JRodrigoTech/ESP32-Reflow-Toaster-Oven-Controller/Hardware/Reflow-controller-ESP32.brd

## EAGLE design Hardware/Reflow-controller-ESP32.brd (2019-05-02)

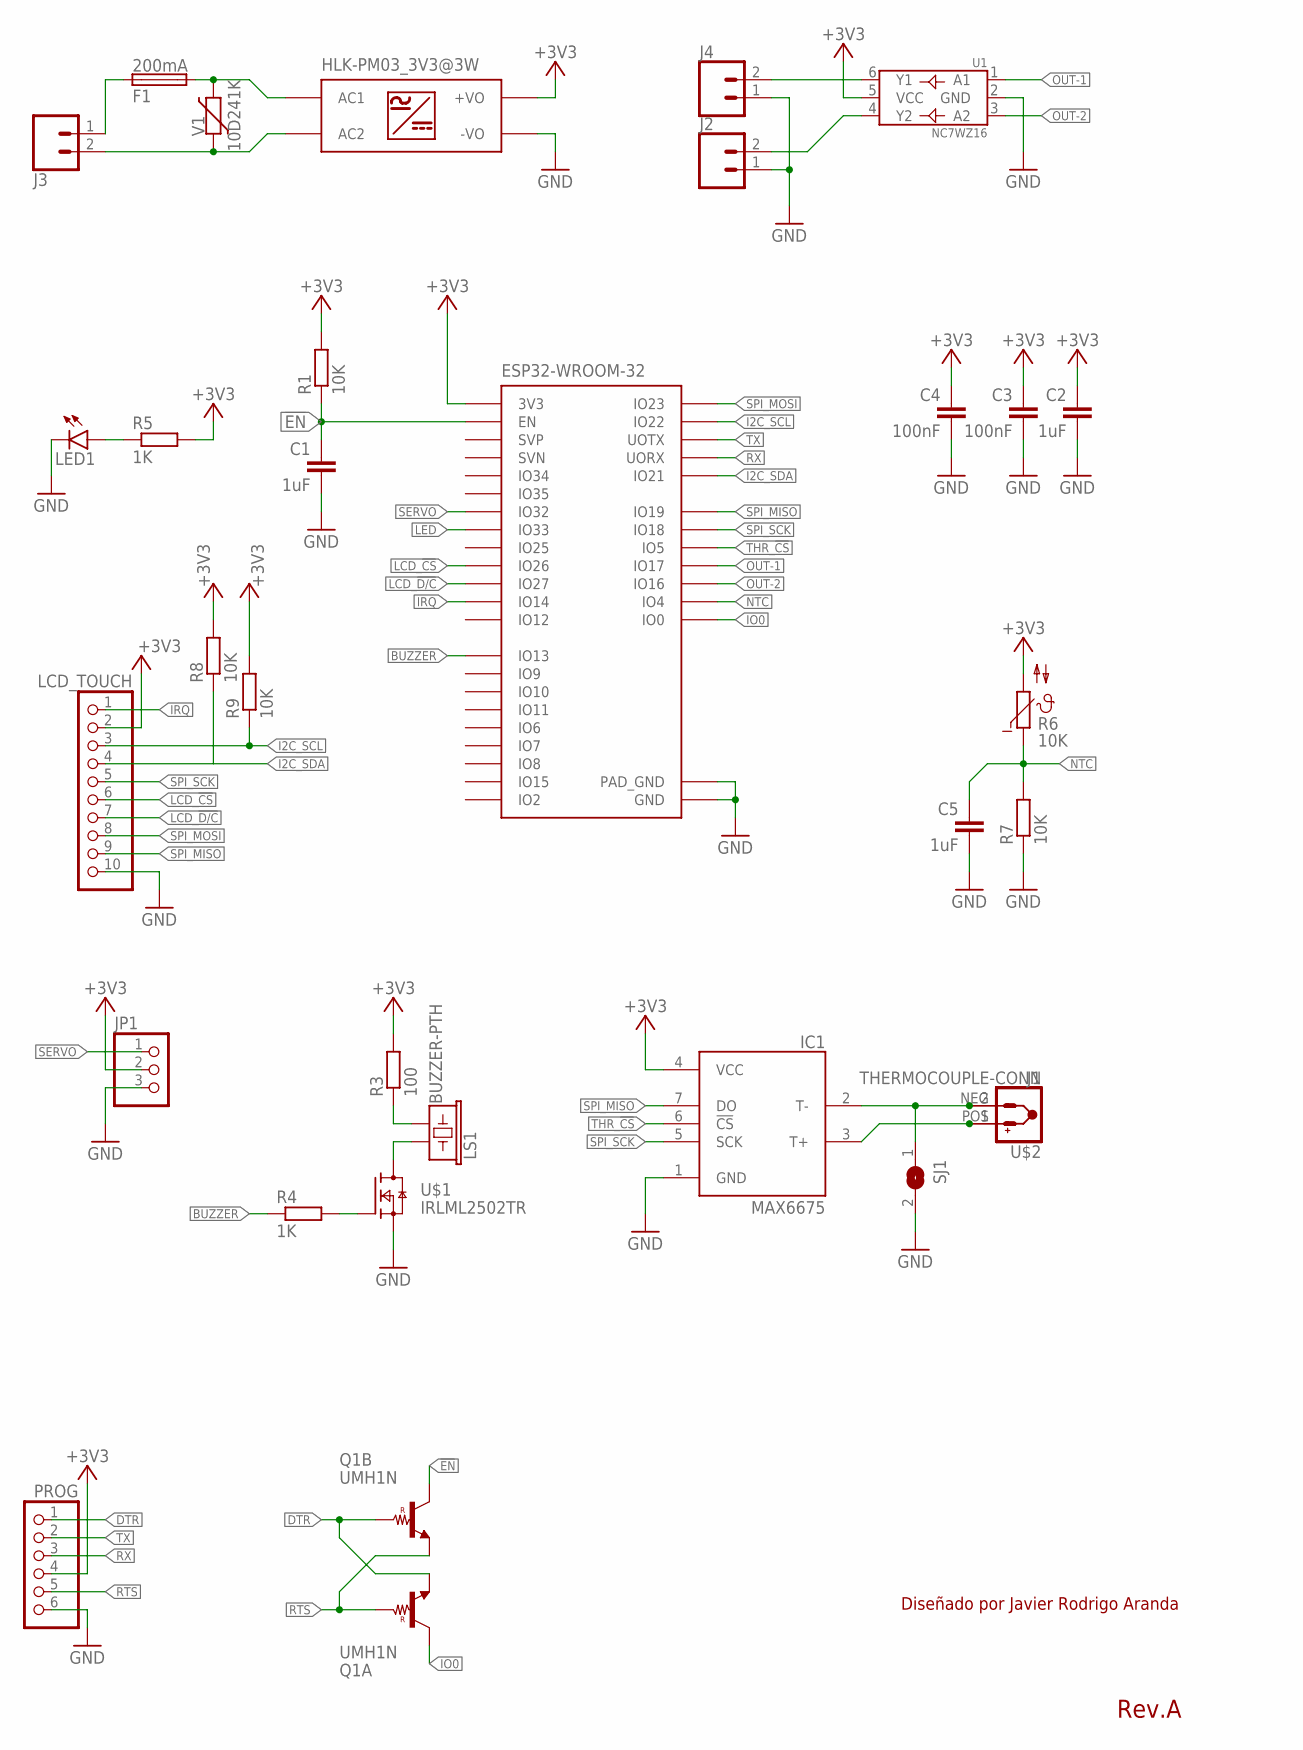
[picture p1: schematic Reflow-controller-ESP32.sch]

Parts:
C1, C2, C5: 1uF; C0805
C3, C4: 100nF; C0805
ESP32-WROOM-32: ESP32; ESP32-WROOM-32
F1: 200mA; SH22,5
HLK-PM03_3V3@3W: HLK-PM0X
IC1: MAX6675; SO08
J1, J2, J3, J4: HEADER_01X025MM-BIG; SCREWTERMINAL-5MM-BIG-BLOCK
JP1: PINHD-1X3; 1X03
LCD_TOUCH: PINHD-1X10; 1X10
LED1: LEDSML1206; SML1206
LS1: BUZZER-PTH; BUZZER-12MM
PROG: PINHD-1X6; 1X06
Q1: UMH1N; UMT6
R1, R7, R8, R9: 10K; R0805
R3: 100; R0805
R4, R5: 1K; R0805
R6: 10K; P642
SJ1: SJ
U1: NC7WZ16; SC-70-6
U$1: IRLML2502TR; SOT23-3
U$2: THERMOCOUPLE-CONN; THERMOCOUPLE-ONBOARD-CONN
V1: 10D241K; R-7,5

Connections:
!EN: C1.1, ESP32-WROOM-32.3 (EN), Q1.3 (C), R1.1
+3V3: C2.1, C3.1, C4.1, ESP32-WROOM-32.2 (3V3), HLK-PM03_3V3@3W.P$4 (+VO), IC1.4 (VCC), JP1.2, LCD_TOUCH.2, PROG.4, R1.2, R3.2, R5.2, R6.2, R8.2, R9.2, U1.5 (VCC)
AC+: HLK-PM03_3V3@3W.P$2 (AC2), J3.2, V1.1
AC-: F1.2, HLK-PM03_3V3@3W.P$1 (AC1), V1.2
BOUT1: J4.2, U1.6 (Y1)
BOUT2: J2.2, U1.4 (Y2)
BUZZER: ESP32-WROOM-32.16 (IO13), R4.1
DTR: PROG.1, Q1.1 (E), Q1.5 (B)
GND: C1.2, C2.2, C3.2, C4.2, C5.2, ESP32-WROOM-32.1 (GND), ESP32-WROOM-32.15 (GND), ESP32-WROOM-32.38 (GND), ESP32-WROOM-32.GND (PAD_GND), HLK-PM03_3V3@3W.P$3 (-VO), IC1.1 (GND), J2.1, J4.1, JP1.3, LCD_TOUCH.10, LED1.C, PROG.6, R7.1, SJ1.2, U1.2 (GND), U$1.2 (S)
I2C_SCL: ESP32-WROOM-32.36 (IO22), LCD_TOUCH.3, R9.1
I2C_SDA: ESP32-WROOM-32.33 (IO21), LCD_TOUCH.4, R8.1
IO0: ESP32-WROOM-32.25 (IO0), Q1.6 (C)
IRQ: ESP32-WROOM-32.13 (IO14), LCD_TOUCH.1
LCD_!CS: ESP32-WROOM-32.11 (IO26), LCD_TOUCH.6
LCD_!D/C: ESP32-WROOM-32.12 (IO27), LCD_TOUCH.7
LED: ESP32-WROOM-32.9 (IO33)
unnamed: F1.1, J3.1
unnamed: LED1.A, R5.1
unnamed: IC1.3 (T+), J1.1, U$2.POS
unnamed: LS1.- (2), R3.1
unnamed: LS1.+ (1), U$1.3 (D)
unnamed: R4.2, U$1.1 (G)
unnamed: IC1.2 (T-), J1.2, SJ1.1, U$2.NEG
NTC: C5.1, ESP32-WROOM-32.26 (IO4), R6.1, R7.2
OUT-1: ESP32-WROOM-32.28 (IO17), U1.1 (A1)
OUT-2: ESP32-WROOM-32.27 (IO16), U1.3 (A2)
RTS: PROG.5, Q1.2 (B), Q1.4 (E)
RX: ESP32-WROOM-32.34 (UORX), PROG.3
SERVO: ESP32-WROOM-32.8 (IO32), JP1.1
SPI_MISO: ESP32-WROOM-32.31 (IO19), IC1.7 (DO), LCD_TOUCH.9
SPI_MOSI: ESP32-WROOM-32.37 (IO23), LCD_TOUCH.8
SPI_SCK: ESP32-WROOM-32.30 (IO18), IC1.5 (SCK), LCD_TOUCH.5
THR_!CS: ESP32-WROOM-32.29 (IO5), IC1.6 (!CS)
TX: ESP32-WROOM-32.35 (UOTX), PROG.2

Notes on the sheet:
Rev.A
Diseñado por Javier Rodrigo Aranda

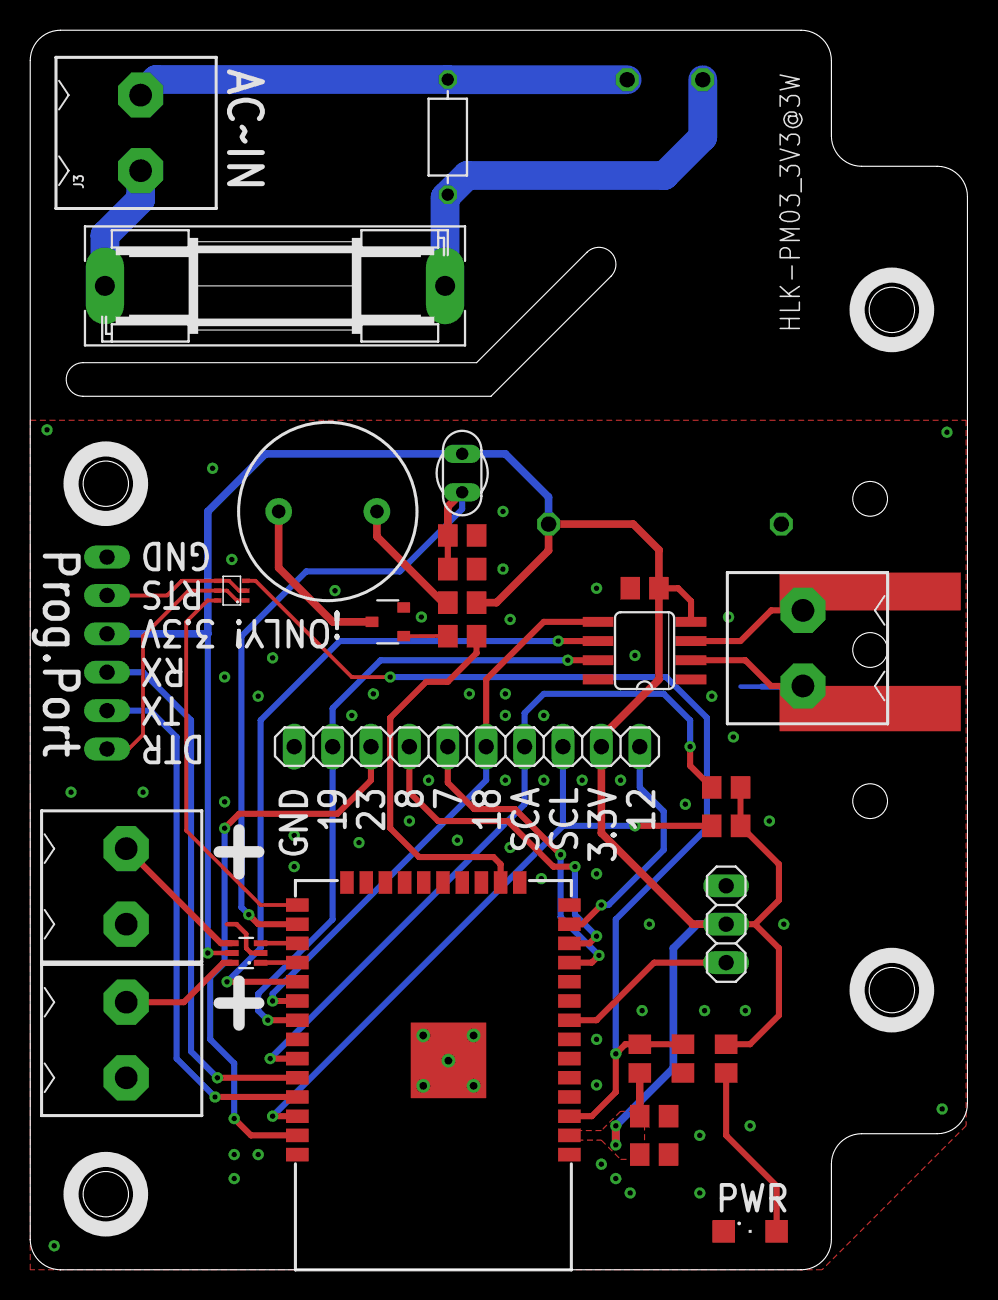
[picture p2: board Reflow-controller-ESP32.brd from above]

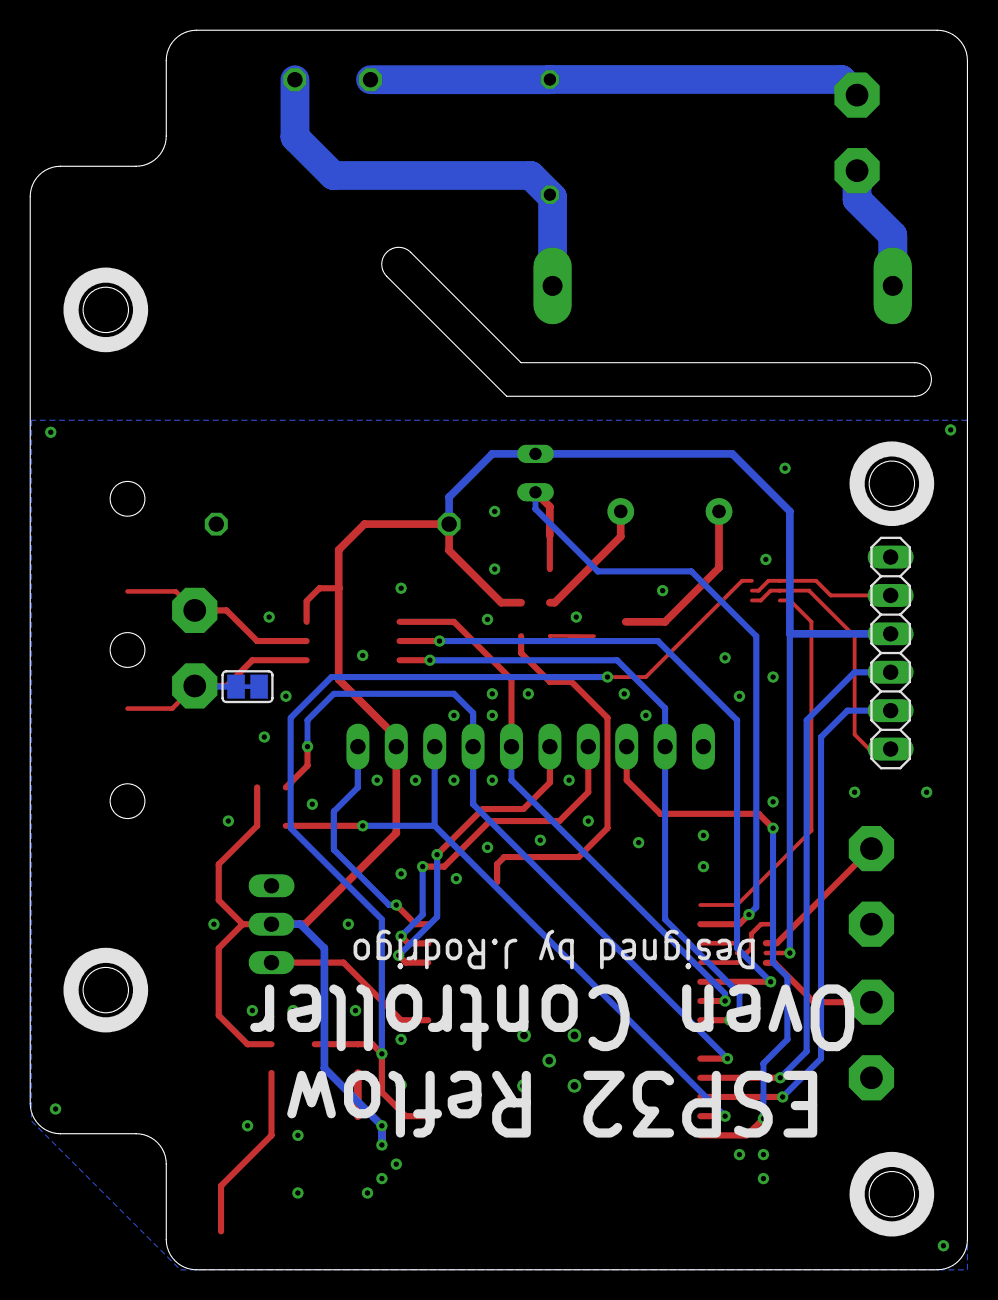
[picture p3: board Reflow-controller-ESP32.brd from below]

Board: 2 copper layers, 62.0 x 82.0 mm, 32 parts (2 on the bottom side), 33 nets.
