JRodrigoTech/ESP32-Reflow-Toaster-Oven-Controller/Hardware/LCD-Touch-Exp.brd

## EAGLE design Hardware/LCD-Touch-Exp.brd (2019-05-02)

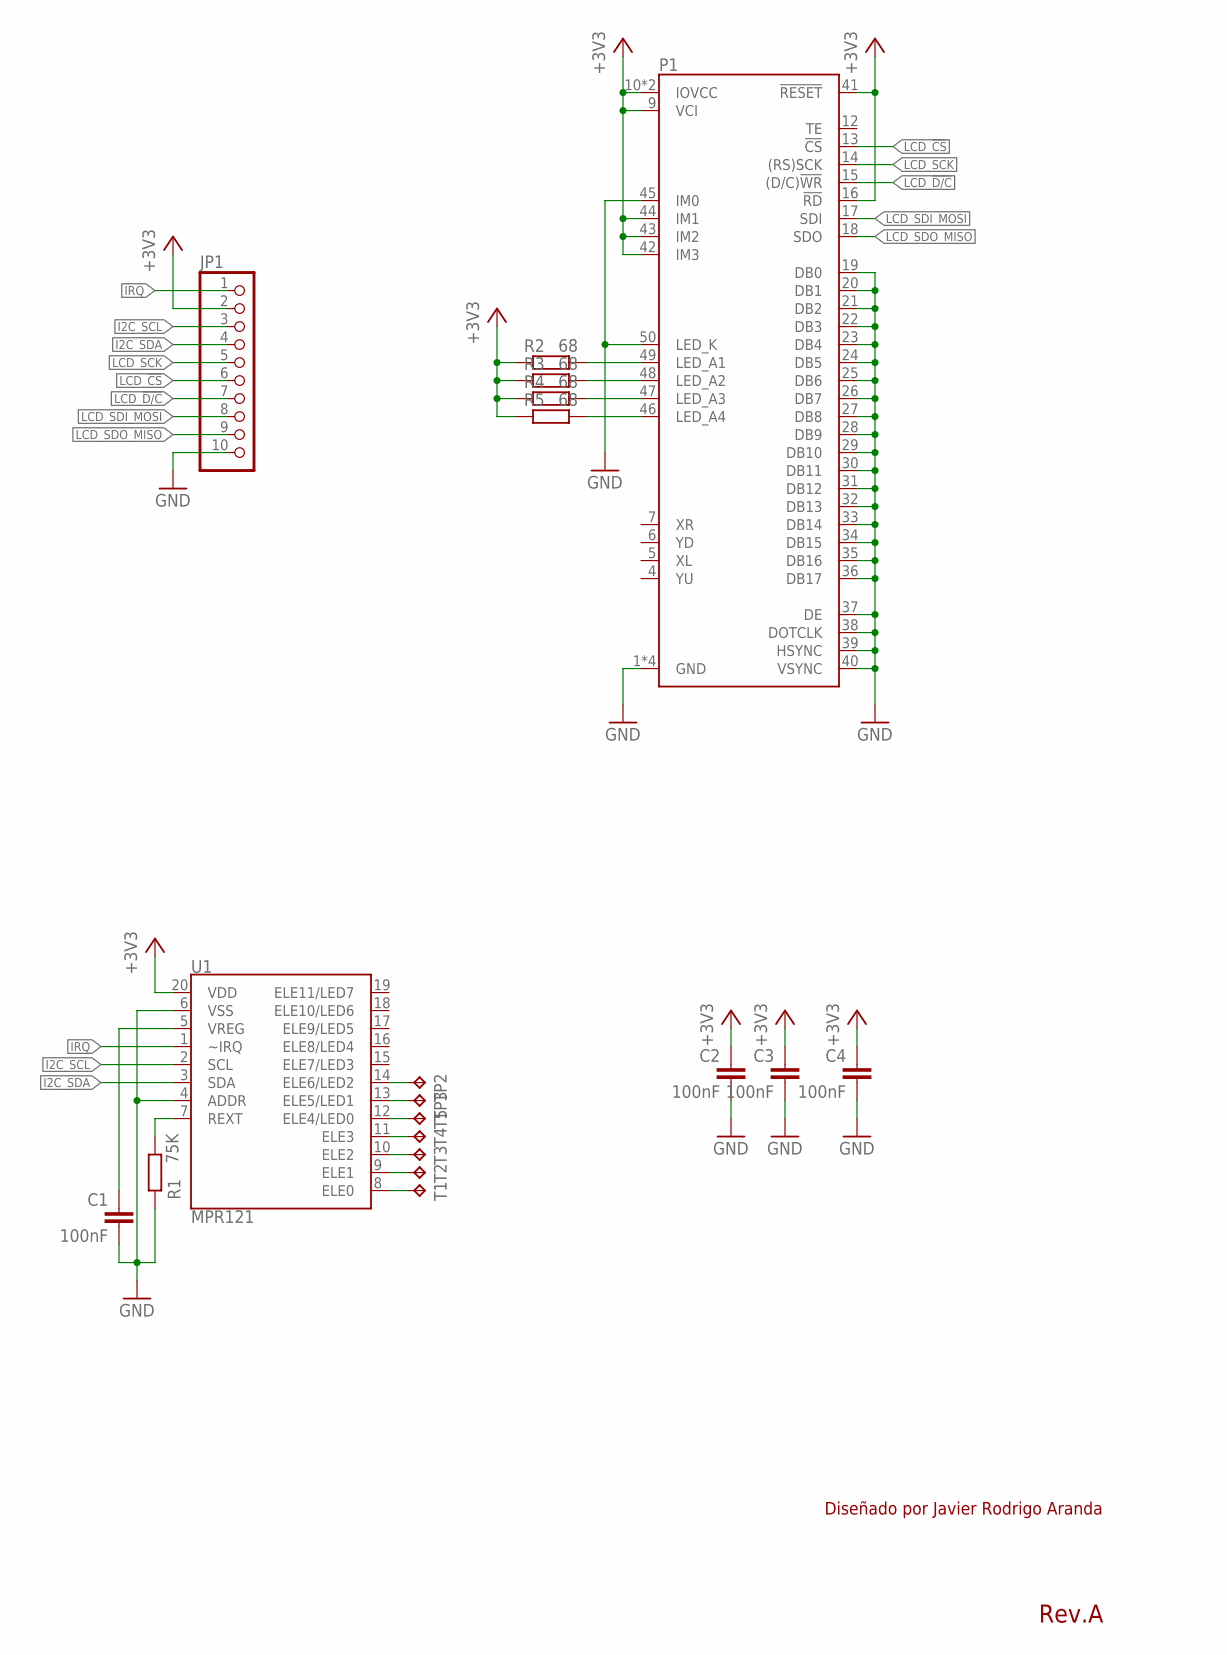
[picture p4: schematic LCD-Touch-Exp.sch]

Parts:
C1, C2, C3, C4: 100nF; C0805
JP1: HEADER-1X10SMT; 1X10_SMT
P1: LCD_ILI9341180º; FPC-50P-0.5MM
R1: 75K; R0805
R2, R3, R4, R5: 68; R0603
T1, T2, T3, T4, T5: TPB1,27; B1,27
TP2, TP3: TPB1,27; B1,27
U1: MPR121; QFN-20

Connections:
+3V3: C2.1, C3.1, C4.1, JP1.2, P1.9 (VCI), P1.10 (IOVCC), P1.11 (IOVCC), P1.16 (!RD), P1.41 (!RESET), P1.42 (IM3), P1.43 (IM2), P1.44 (IM1), R2.2, R3.2, R4.2, R5.2, U1.20 (VDD)
GND: C1.2, C2.2, C3.2, C4.2, JP1.10, P1.1 (GND), P1.2 (GND), P1.3 (GND), P1.8 (GND), P1.19 (DB0), P1.20 (DB1), P1.21 (DB2), P1.22 (DB3), P1.23 (DB4), P1.24 (DB5), P1.25 (DB6), P1.26 (DB7), P1.27 (DB8), P1.28 (DB9), P1.29 (DB10), P1.30 (DB11), P1.31 (DB12), P1.32 (DB13), P1.33 (DB14), P1.34 (DB15), P1.35 (DB16), P1.36 (DB17), P1.37 (DE), P1.38 (DOTCLK), P1.39 (HSYNC), P1.40 (VSYNC), P1.45 (IM0), P1.50 (LED_K), R1.1, U1.4 (ADDR), U1.6 (VSS)
I2C_SCL: JP1.3, U1.2 (SCL)
I2C_SDA: JP1.4, U1.3 (SDA)
IRQ: JP1.1, U1.1 (~IRQ)
LCD_!CS: JP1.6, P1.13 (!CS)
LCD_!D/C: JP1.7, P1.15 ((D/C)!WR!)
LCD_SCK: JP1.5, P1.14 ((RS)SCK)
LCD_SDI_MOSI: JP1.8, P1.17 (SDI)
LCD_SDO_MISO: JP1.9, P1.18 (SDO)
unnamed: R1.2, U1.7 (REXT)
unnamed: T1.TP, U1.8 (ELE0)
unnamed: T2.TP, U1.9 (ELE1)
unnamed: T3.TP, U1.10 (ELE2)
unnamed: T4.TP, U1.11 (ELE3)
unnamed: T5.TP, U1.12 (ELE4/LED0)
unnamed: TP3.TP, U1.13 (ELE5/LED1)
unnamed: TP2.TP, U1.14 (ELE6/LED2)
unnamed: P1.49 (LED_A1), R2.1
unnamed: P1.48 (LED_A2), R3.1
unnamed: P1.47 (LED_A3), R4.1
unnamed: P1.46 (LED_A4), R5.1
unnamed: C1.1, U1.5 (VREG)

Notes on the sheet:
Rev.A
Diseñado por Javier Rodrigo Aranda

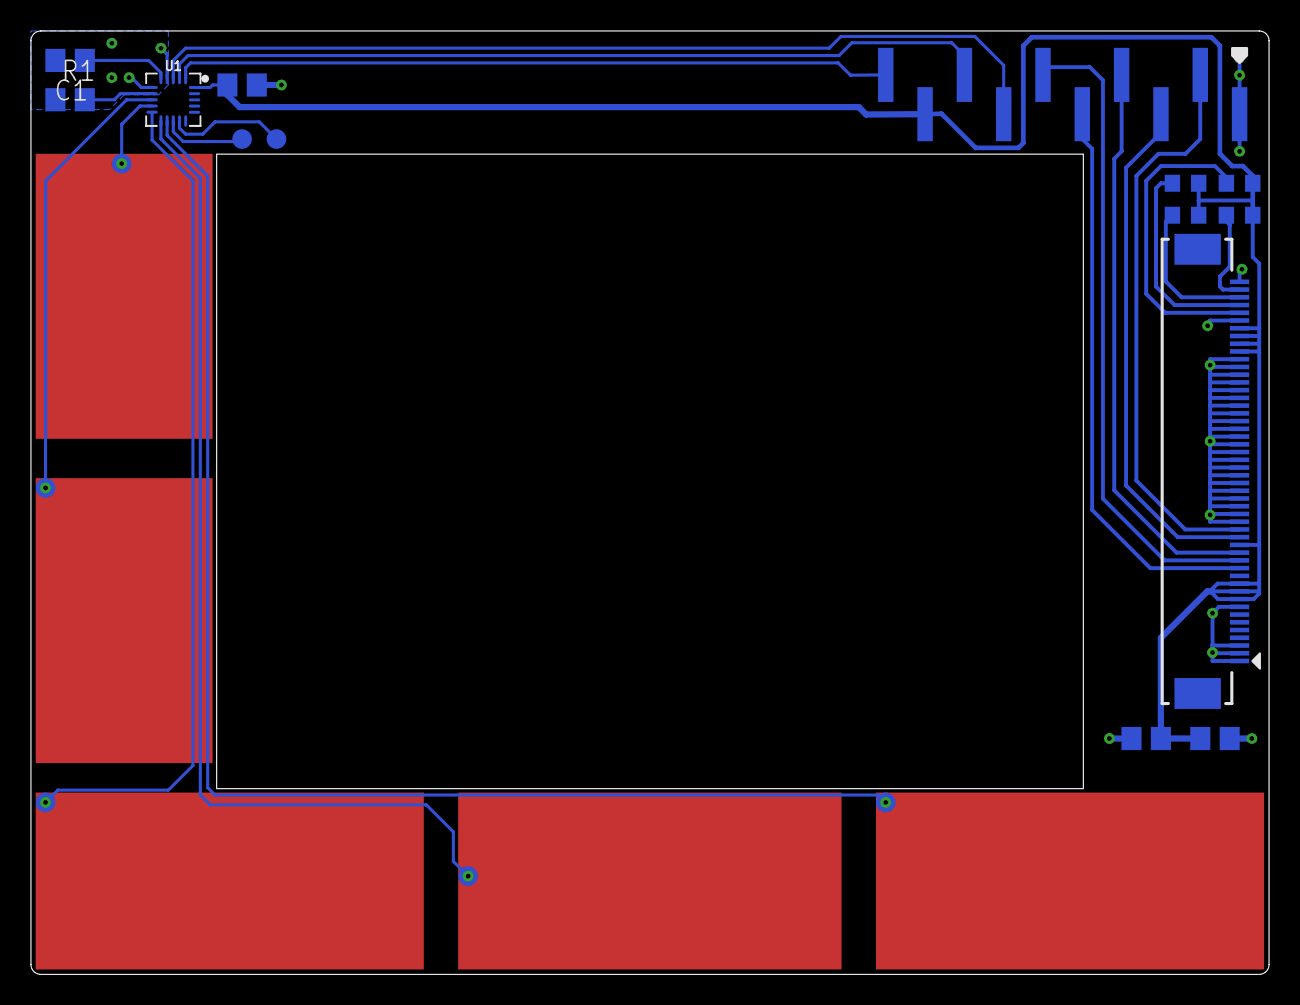
[picture p5: board LCD-Touch-Exp.brd from below]

Board: 2 copper layers, 80.0 x 61.0 mm, 19 parts (19 on the bottom side), 23 nets.
