JRodrigoTech/ESP32-Reflow-Toaster-Oven-Controller/Software/Variables.h

// PIN DEFINITIONS //
#define SSR_PIN 17
#define STATUS_LED 33
// SPI LCD PINS
#define TFT_DC 27
#define TFT_CS 26
#define TFT_MOSI 23
#define TFT_CLK 18
#define TFT_RST 14
#define TFT_MISO 19
// MAX6675 Pins
#define thermoDO 19
#define thermoCS 5
#define thermoCLK 18

// Time Out for AP MODE
const int     conn_time_out = 10000 ;     // in ms
int           time_out = 0 ;

// Server Settings //
const byte    DNS_PORT = 53;          // Capture DNS requests on port 53
IPAddress     apIP(192, 168, 4, 1);    // Private network for server in AP MODE
DNSServer     dnsServer;              // Create the DNS object
WebServer     webServer(80);          // HTTP server
boolean       AP_MODE = false;

// Dual Core Control loop on CORE 0
TaskHandle_t  Tloop0;
boolean       REFLOW_STATUS = false;      // Reflow process status (on/off)
boolean       prev_REFLOW_STATUS = false;

// No delay variables
unsigned long currentMillis;
unsigned long control_flag;
unsigned long acquisition_flag;
unsigned long plot_flag;
unsigned long PWM_flag;
unsigned long reflow_wait;
long PWM_period = 1000;

// Reflow Control variables
int temps_pos, temp_acqui, prev_temp_acqui, Degsec, reflow_pos;

// Live Plot Data Arrays
int plotdata[276];
int plotleg=0;

// LCD CUSTOM COLORS
#define LIGHT_YELLOW 0xFFF0
#define LIGHT_GRAY 0xDEFB
#define DARK_RED 0x9800
