JRodrigoTech/ESP32-Reflow-Toaster-Oven-Controller/(commit log)

2019-04-01 Improved canvas plot
    - Live reflow plot temperature
    - Simplified some functions of the code
    - Print current local IP
2019-04-02 First profile temperature controller
    - Implemented a proportional ramp profile controller
    - "Variables.h" file created for variables and definitions
2019-04-02 Minimal Fix
    - EEPROM_FUNCTIONS.h changed to EEPROM.h
    - The code has been cleaned up
    [Variables.h]
2019-05-02 Added first hardware revision
    [LCD-Touch-Exp.brd, LCD-Touch-Exp.sch, Reflow-controller-ESP32.brd, Reflow-controller-ESP32.sch]
