JRodrigoTech/ESP32-Reflow-Toaster-Oven-Controller/(notices)

Notices in the files:
parts and their libraries:
SparkFun-Sensors: Licensing: Creative Commons ShareAlike 4.0 International - https://creativecommons.org/licenses/by-sa/4.0
jrodrigo: Creative Commons - Attribution and Share Alike 4.0 International - https://creativecommons.org/licenses/by-sa/4.0
